MaybeBrain/Four-Channel-Grayscale-Sensor-Line-Following-Car/Hardware/Motor.h

#ifndef _MOTOR_H
#define _MOTOR_H

void Motor_Init(void);
void Motor_Forward(void);
void Motor_Backward(void);
void Motor_Stop(void);
void Motor_TurnLeft(void); 
void Motor_TurnRight(void);






#endif
