MaybeBrain/Four-Channel-Grayscale-Sensor-Line-Following-Car/(commit log)

2026-09-14 添加.gitignore文件
2026-09-14 chore: 添加 .gitignore 清理编译产物
2026-09-15 添加images文件夹存放实物图
2026-09-15 优化README
2026-09-16 更新README信息
2026-09-16 在README中添加调试日志
2026-09-16 调整了调试日志的位置
